crice009/CountertopIncubator/docs/images/render1.png

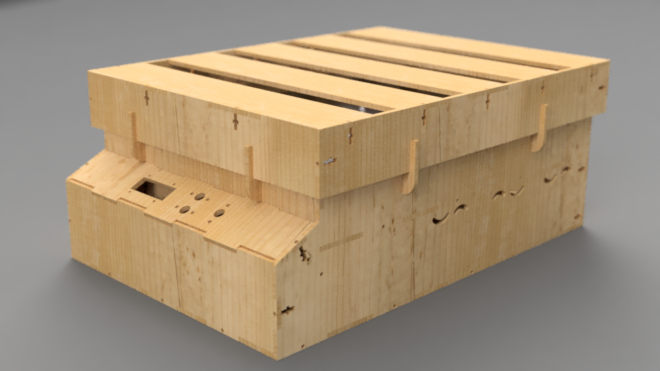
docs/images/render1.png
