crice009/CountertopIncubator/docs/images/pic1.jpg

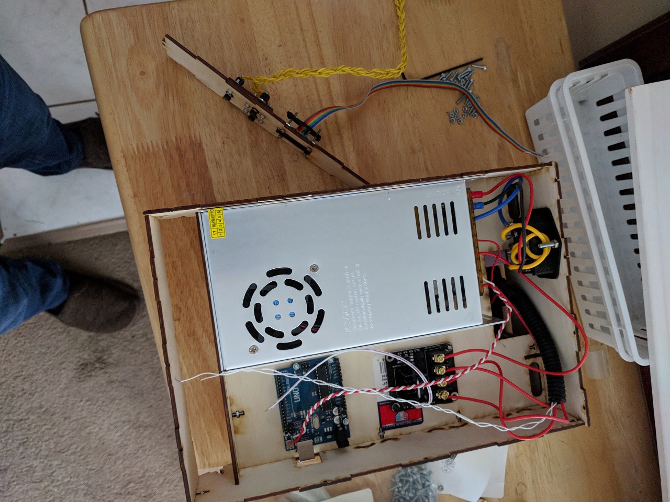
docs/images/pic1.jpg
