crice009/CountertopIncubator/README.md

# Countertop Incubator
Incubator for making tempeh built from spare 3D printer parts. Specifically designed to meet the discerning needs of a hungry girlfriend, with a background in microbiology..

# Documentation Website
https://crice009.github.io/CountertopIncubator/index.html
