crice009/CountertopIncubator/docs/images/1image.png

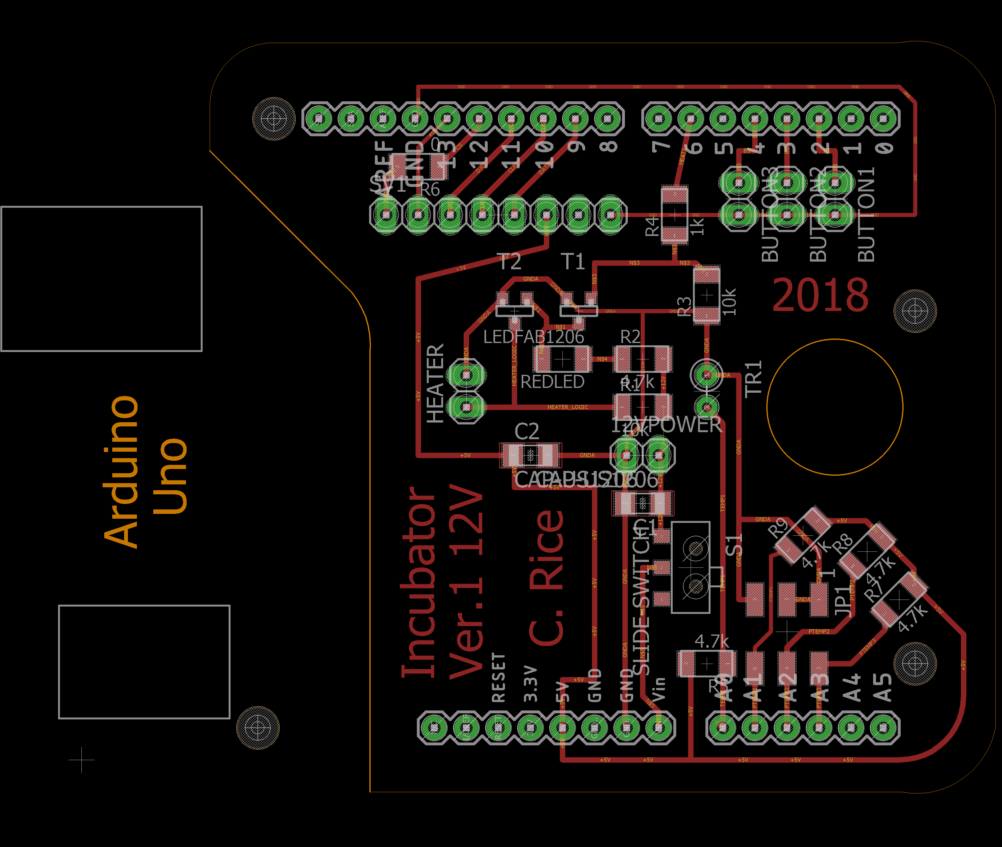
docs/images/1image.png
