crice009/CountertopIncubator/docs/images/dxf_export.png

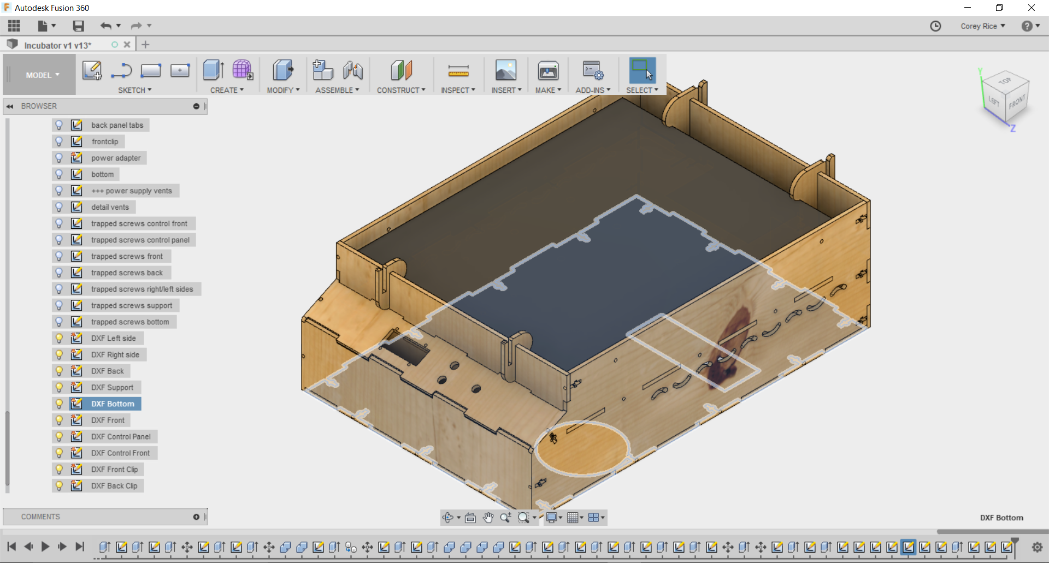
docs/images/dxf_export.png
