crice009/CountertopIncubator/docs/images/gitmarlin.png

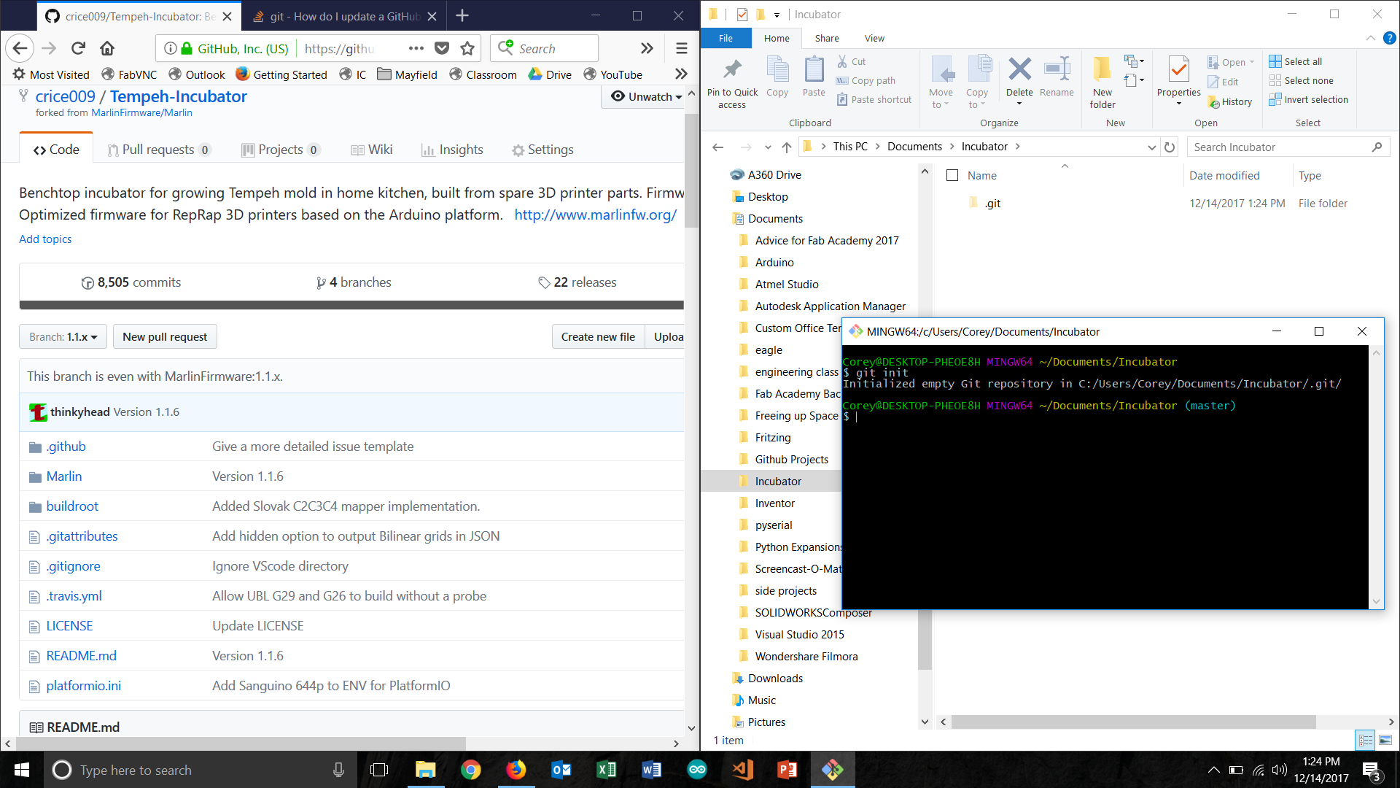
docs/images/gitmarlin.png
