crice009/CountertopIncubator/docs/images/gotmarlin.png

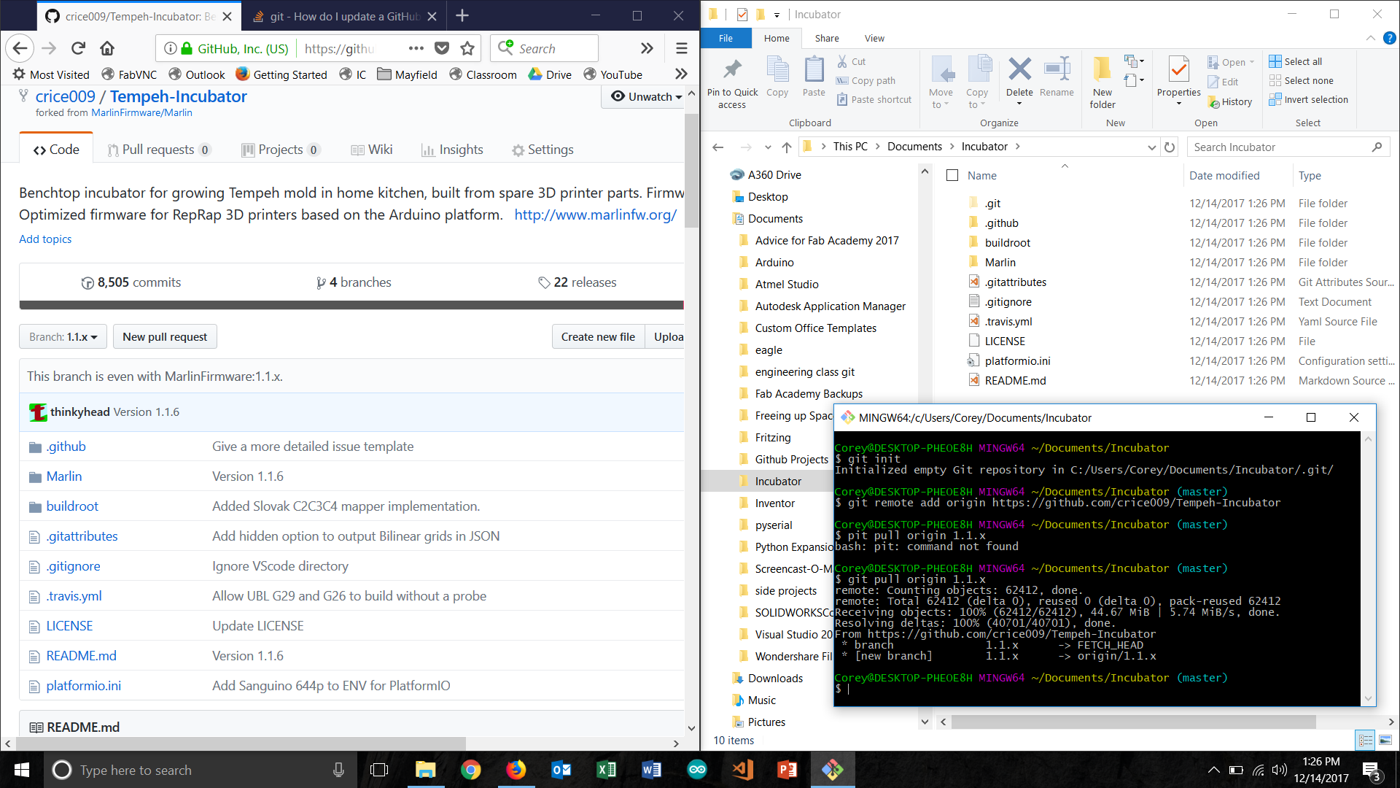
docs/images/gotmarlin.png
