crice009/CountertopIncubator/docs/images/modeling.PNG

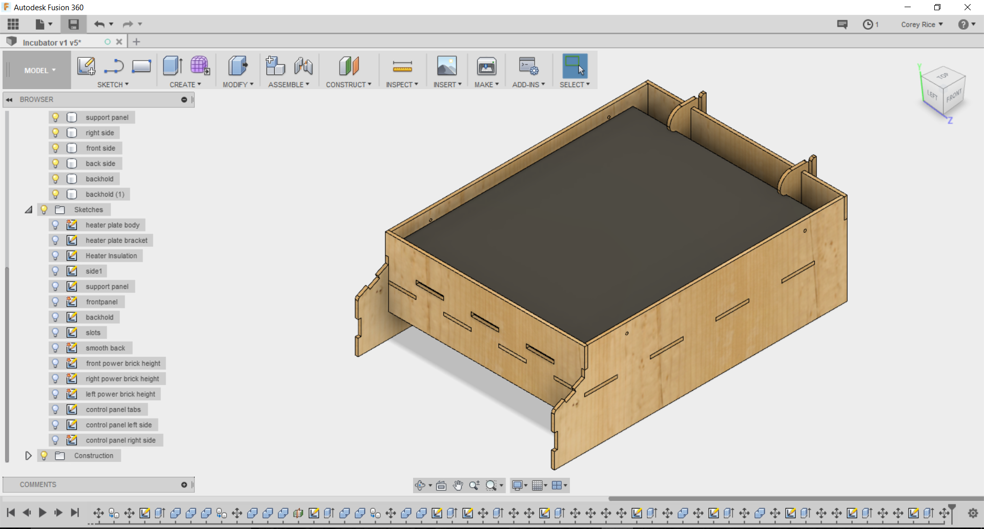
docs/images/modeling.PNG
