crice009/CountertopIncubator/docs/images/pic2.jpg

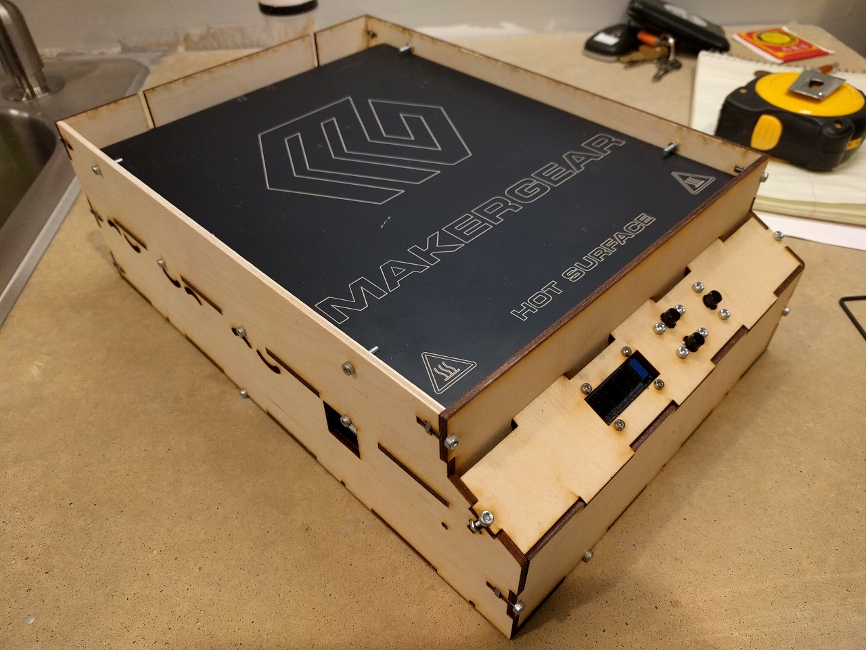
docs/images/pic2.jpg
