crice009/CountertopIncubator/docs/images/render2.png

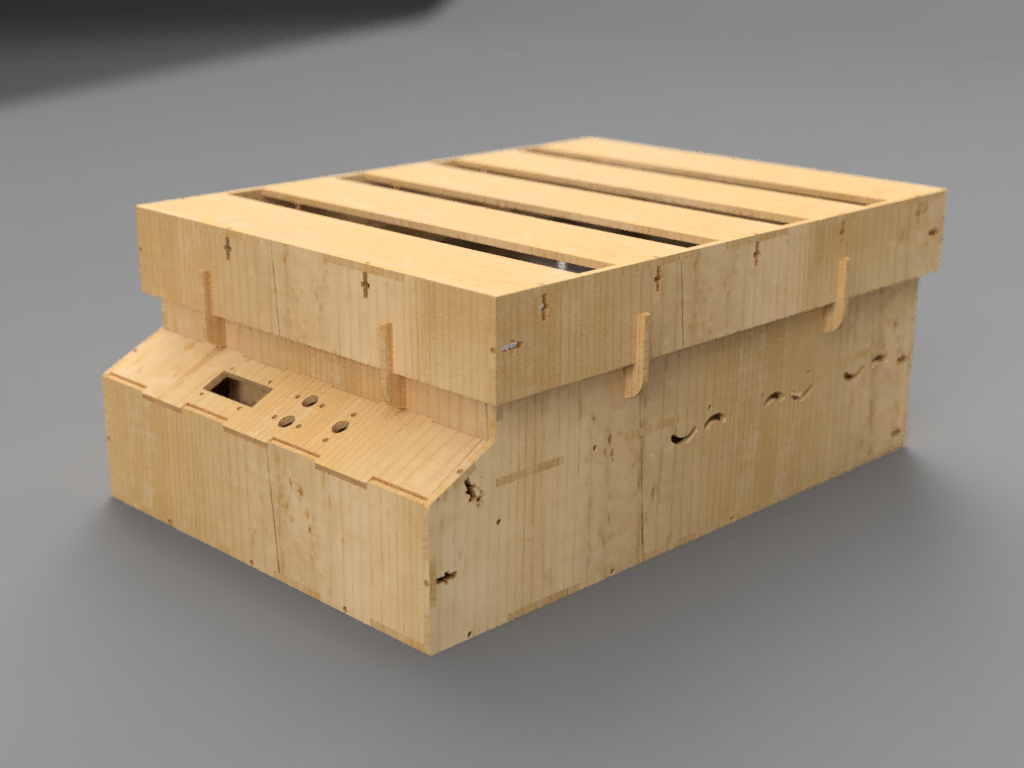
docs/images/render2.png
