crice009/CountertopIncubator/Eagle/design ideas/heated bed circuit (1).png

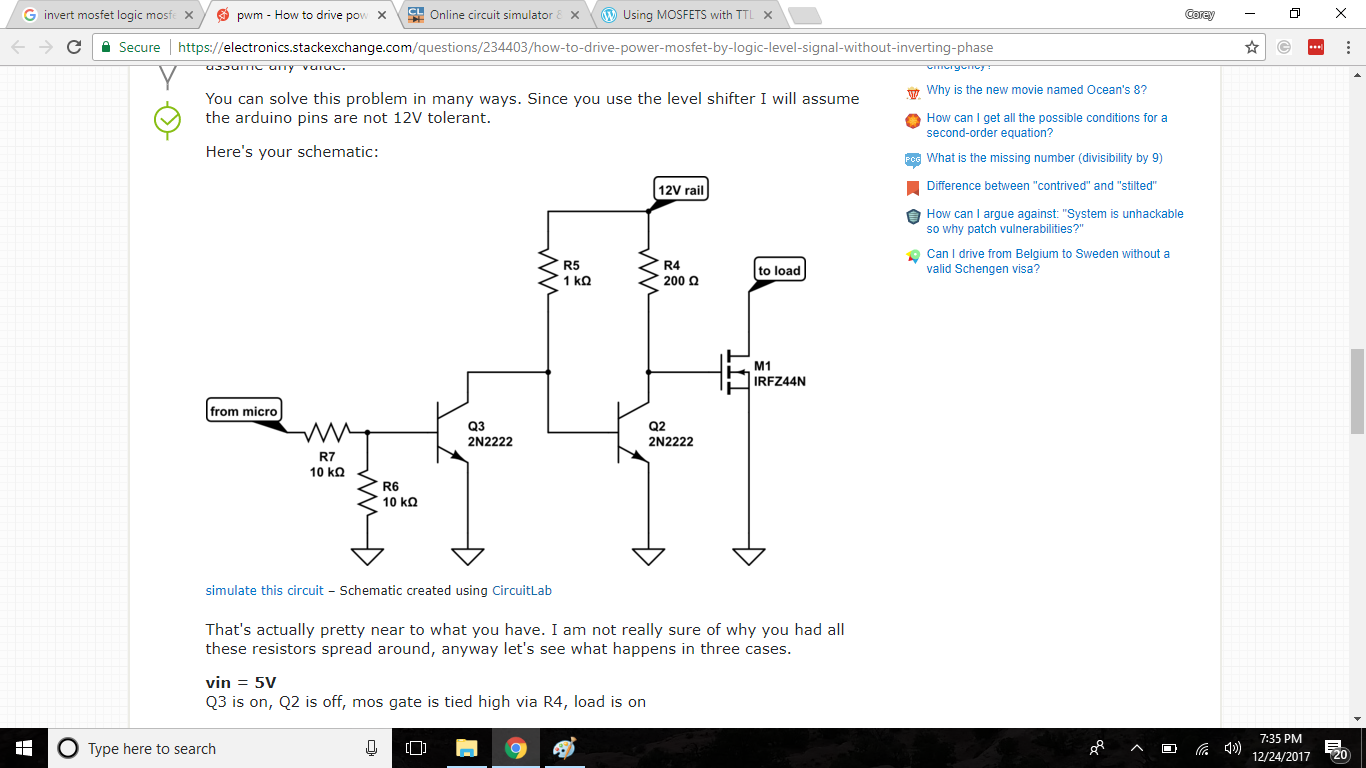
Eagle/design ideas/heated bed circuit (1).png
