crice009/CountertopIncubator/Eagle/design ideas/heated bed circuit (2).png

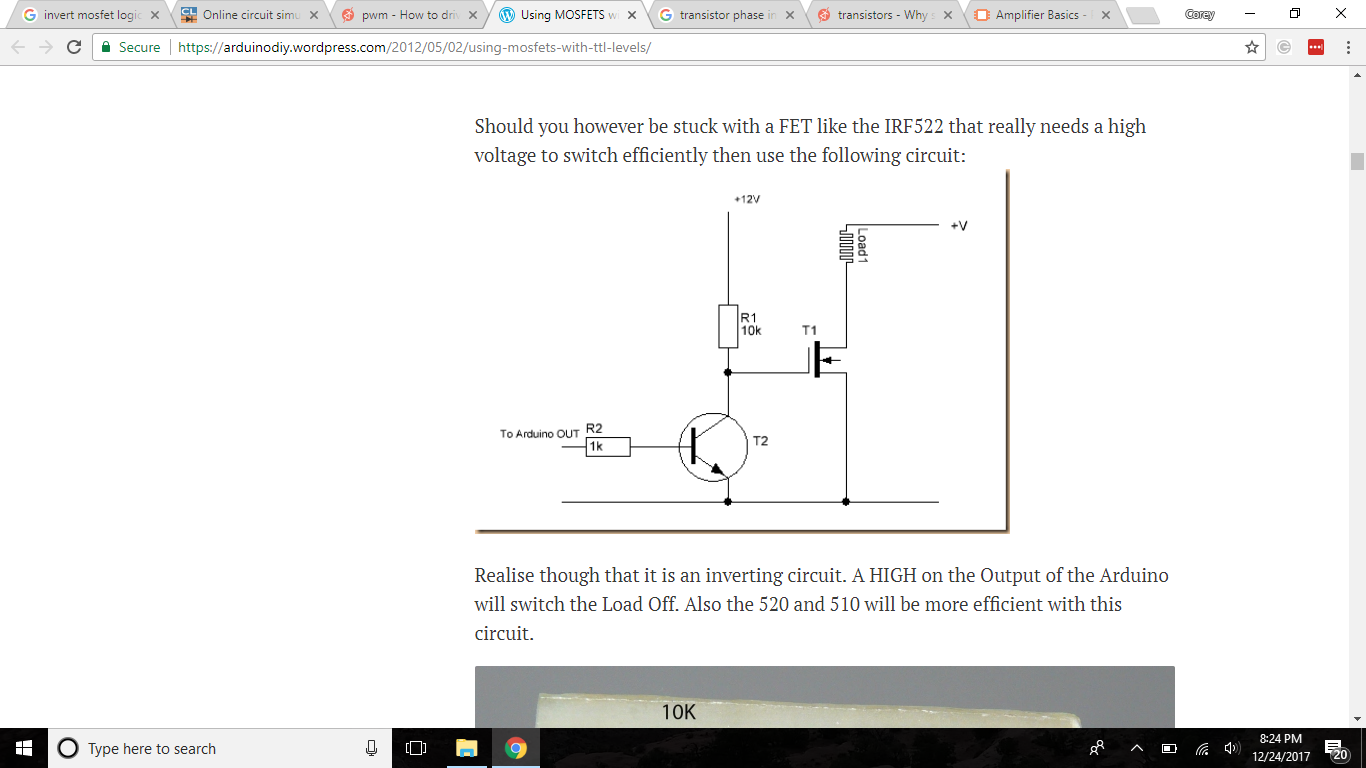
Eagle/design ideas/heated bed circuit (2).png
