crice009/CountertopIncubator/Eagle/design ideas/heated bed circuit.png

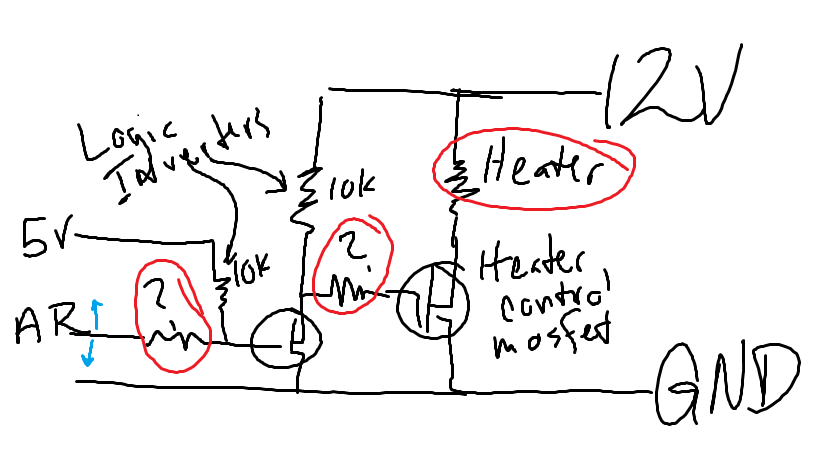
Eagle/design ideas/heated bed circuit.png
