crice009/CountertopIncubator/Eagle/toolpaths/holes.png

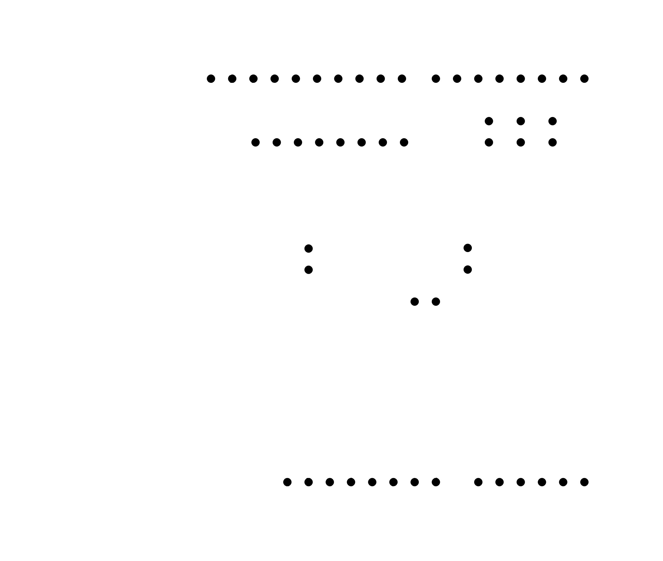
Eagle/toolpaths/holes.png
