crice009/CountertopIncubator/Eagle/toolpaths/outline.png

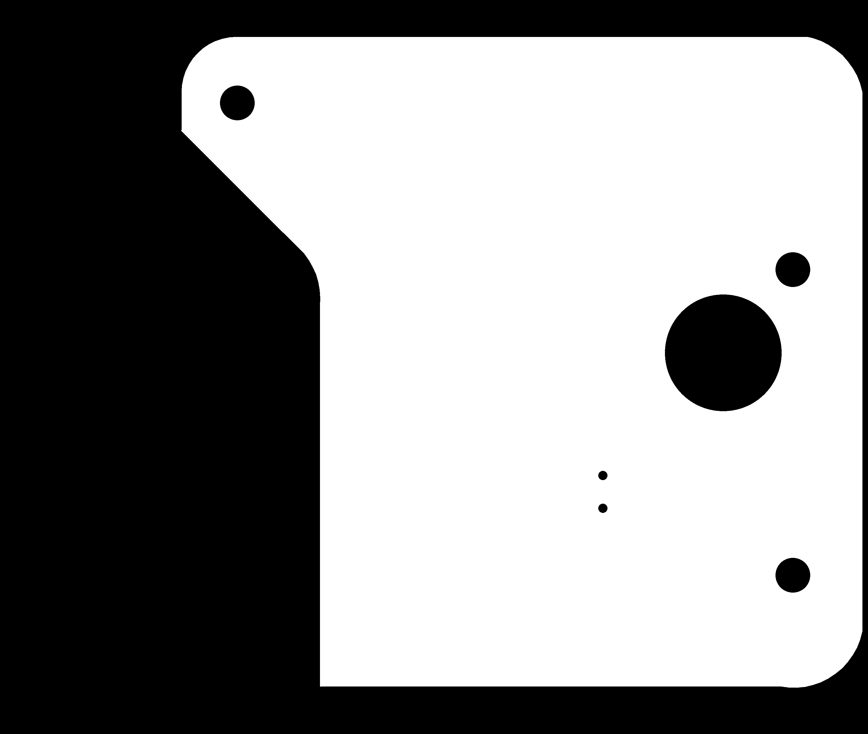
Eagle/toolpaths/outline.png
