crice009/CountertopIncubator/Eagle/toolpaths/traces.png

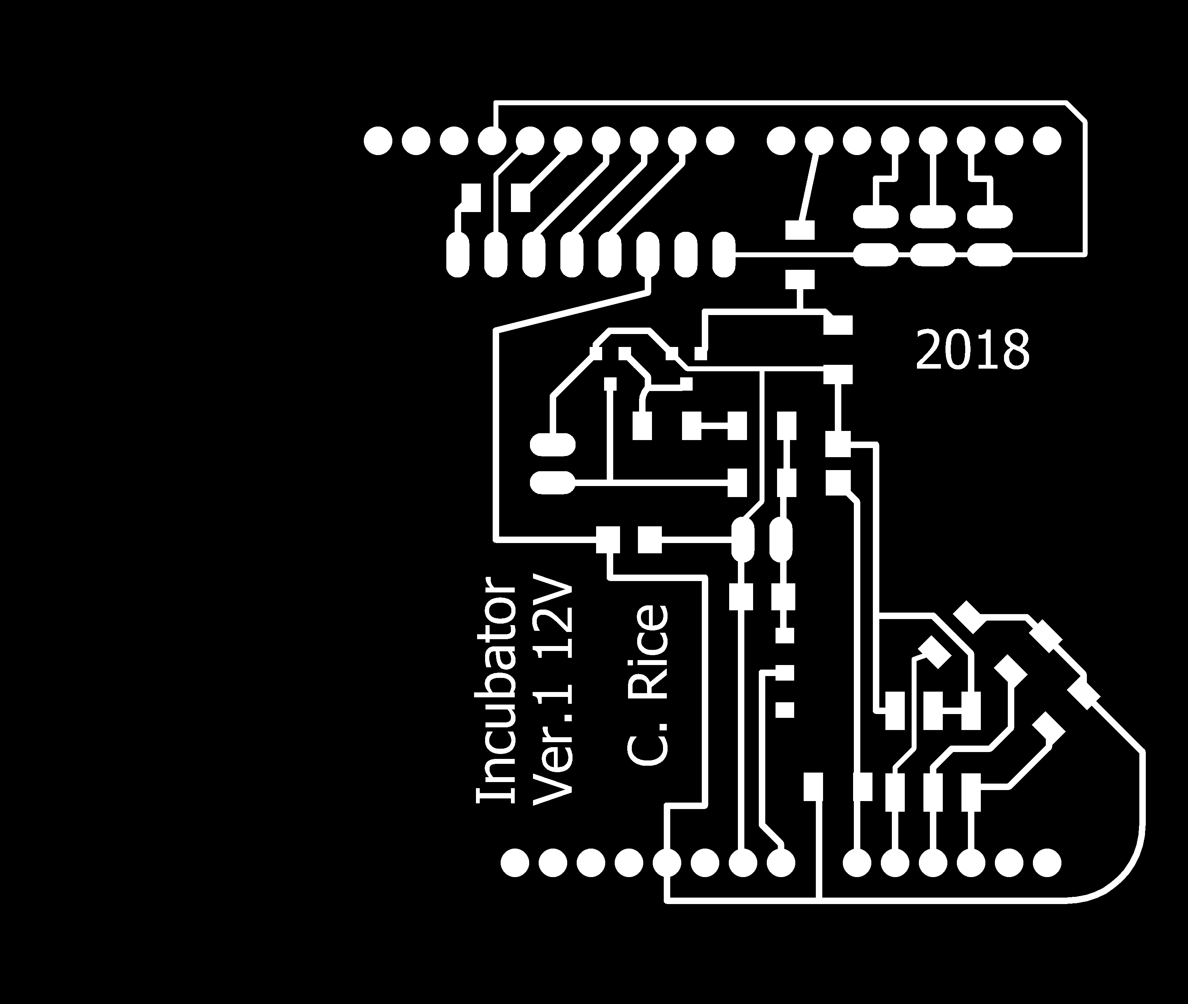
Eagle/toolpaths/traces.png
