crice009/CountertopIncubator/Models/DXF_files/DXF_Bottom3.dxf

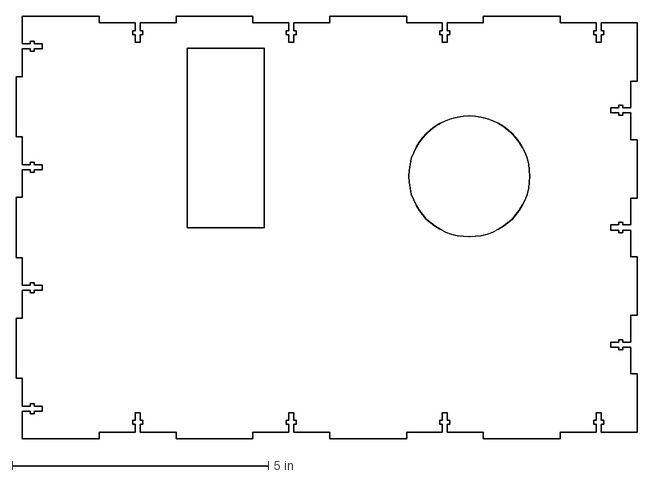
[picture p16: CAD file, 2017-12-29]
Models/DXF_files/DXF_Bottom3.dxf
12.1 x 8.25 in
