crice009/CountertopIncubator/Models/DXF_files/v1/DXF_Bottom.dxf

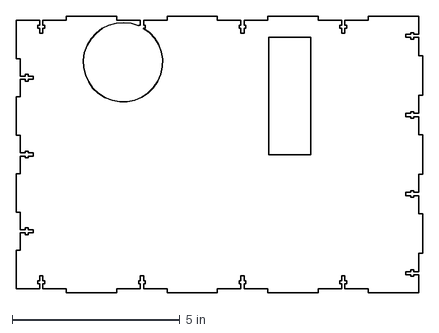
[picture p17: CAD file, 2017-12-29]
Models/DXF_files/v1/DXF_Bottom.dxf
12.1 x 8.25 in
