crice009/CountertopIncubator/Models/DXF_files/v1/DXF_Right.dxf

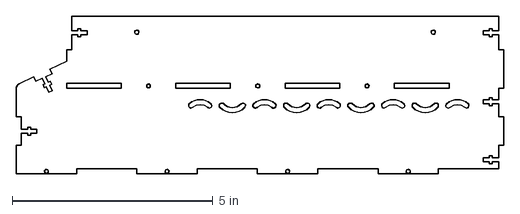
[picture p21: CAD file, 2017-12-29]
Models/DXF_files/v1/DXF_Right.dxf
12.1 x 3.92 in
