crice009/CountertopIncubator/Models/DXF_files/DXF_Left.dxf

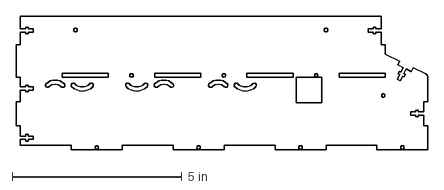
[picture p22: CAD file, 2017-12-29]
Models/DXF_files/DXF_Left.dxf
12.1 x 3.92 in
