crice009/CountertopIncubator/Models/DXF_files/v1/DXF_Back_Clip_2x.dxf

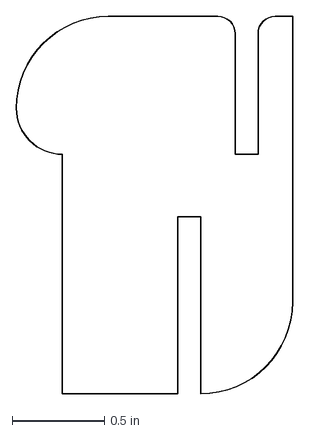
[picture p23: CAD file, 2017-12-29]
Models/DXF_files/v1/DXF_Back_Clip_2x.dxf
1.50 x 2.05 in
