crice009/CountertopIncubator/Models/DXF_files/DXF_Front2.dxf

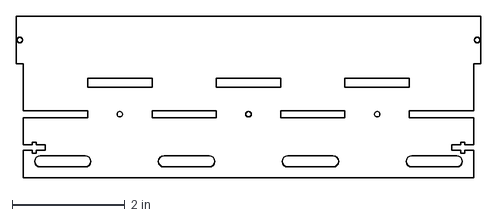
[picture p24: CAD file, 2017-12-29]
Models/DXF_files/DXF_Front2.dxf
8.25 x 2.86 in
