crice009/CountertopIncubator/Models/DXF_files/v1/DXF_Back.dxf

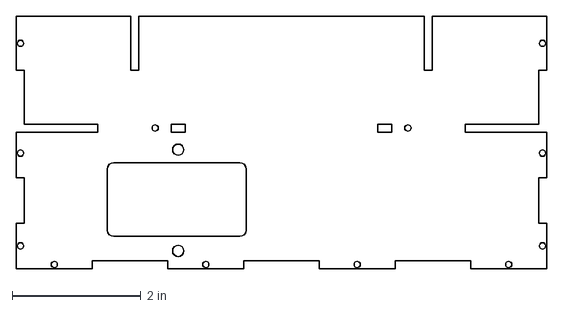
[picture p25: CAD file, 2017-12-29]
Models/DXF_files/v1/DXF_Back.dxf
8.25 x 3.92 in
