crice009/CountertopIncubator/Models/DXF_files/DXF_Support.dxf

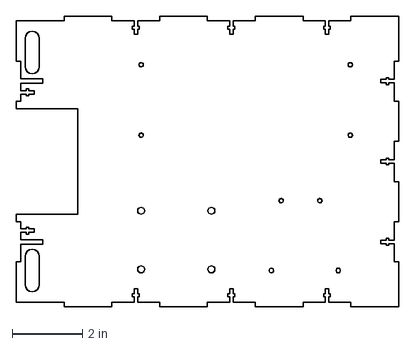
[picture p26: CAD file, 2017-12-29]
Models/DXF_files/DXF_Support.dxf
10.9 x 8.25 in
