crice009/CountertopIncubator/Models/DXF_files/v1/DXF_Control_Panel.dxf

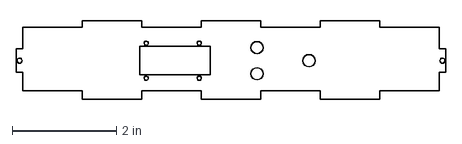
[picture p27: CAD file, 2017-12-29]
Models/DXF_files/v1/DXF_Control_Panel.dxf
8.25 x 1.50 in
