crice009/CountertopIncubator/Models/DXF_files/DXF_Front.dxf

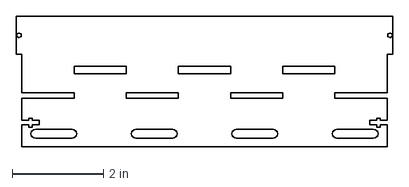
[picture p29: CAD file, 2017-12-29]
Models/DXF_files/DXF_Front.dxf
8.25 x 2.86 in
