crice009/CountertopIncubator/Models/DXF_files/DXF_Button_Panel.dxf

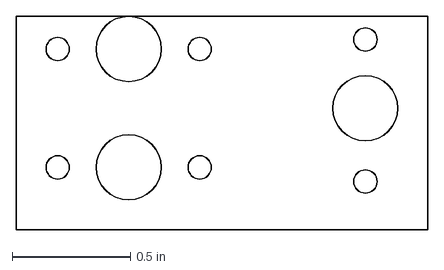
[picture p31: CAD file, 2017-12-29]
Models/DXF_files/DXF_Button_Panel.dxf
1.74 x 0.901 in
