crice009/CountertopIncubator/Models/DXF_files/v1/DXF_Front.dxf

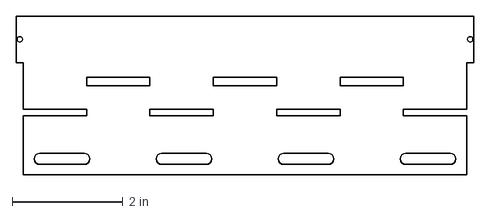
[picture p32: CAD file, 2017-12-29]
Models/DXF_files/v1/DXF_Front.dxf
8.25 x 2.86 in
