crice009/CountertopIncubator/Models/DXF_files/v1/DXF_Front_Clip_2x+.dxf

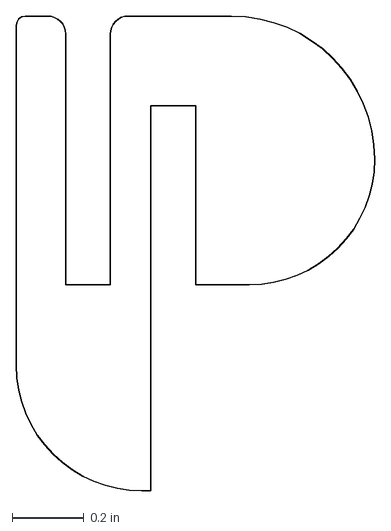
[picture p34: CAD file, 2017-12-29]
Models/DXF_files/v1/DXF_Front_Clip_2x+.dxf
1.00 x 1.33 in
