crice009/CountertopIncubator/Models/DXF_files/DXF_lid_long.dxf

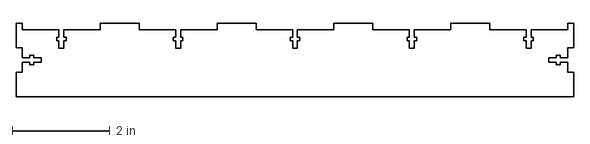
[picture p35: CAD file, 2017-12-29]
Models/DXF_files/DXF_lid_long.dxf
11.4 x 1.50 in
