crice009/CountertopIncubator/Models/DXF_files/DXF_Control_Front.dxf

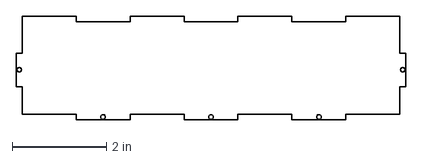
[picture p36: CAD file, 2017-12-29]
Models/DXF_files/DXF_Control_Front.dxf
8.25 x 2.20 in
