crice009/CountertopIncubator/Models/DXF_files/DXF_lid_short.dxf

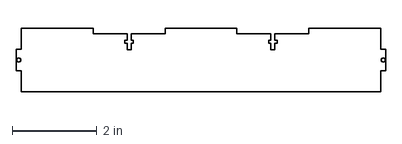
[picture p37: CAD file, 2017-12-29]
Models/DXF_files/DXF_lid_short.dxf
8.73 x 1.50 in
