crice009/CountertopIncubator/Models/DXF_files/DXF_Control_Panel2.dxf

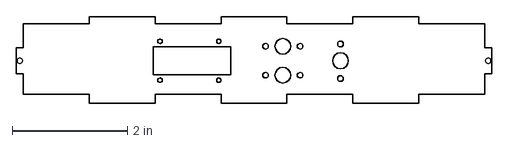
[picture p38: CAD file, 2017-12-29]
Models/DXF_files/DXF_Control_Panel2.dxf
8.25 x 1.50 in
