crice009/CountertopIncubator/Models/DXF_files/DXF_Back_Clip.dxf

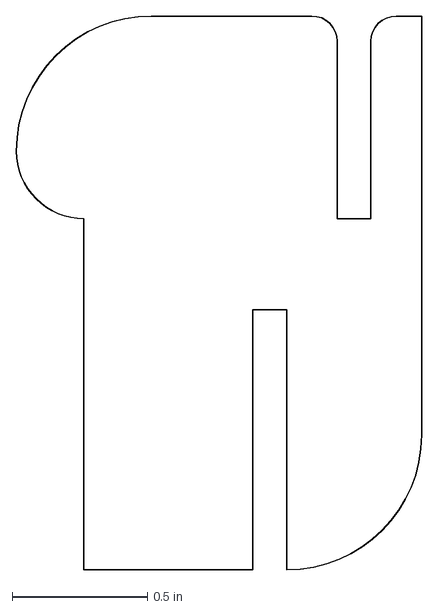
[picture p39: CAD file, 2017-12-29]
Models/DXF_files/DXF_Back_Clip.dxf
1.50 x 2.05 in
