crice009/CountertopIncubator/Models/DXF_files/DXF_Front_Clip.dxf

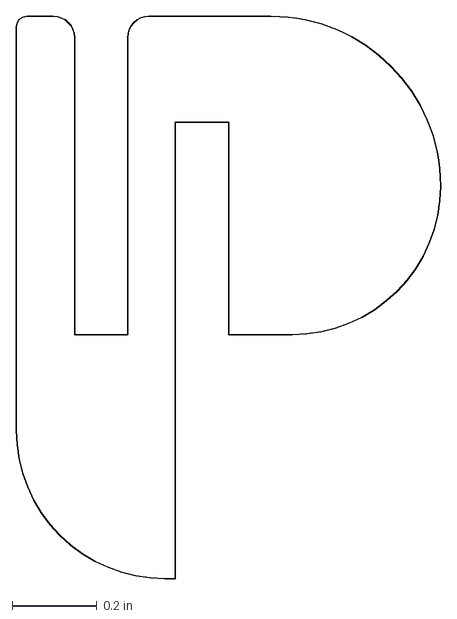
[picture p41: CAD file, 2017-12-29]
Models/DXF_files/DXF_Front_Clip.dxf
1.00 x 1.33 in
