crice009/CountertopIncubator/Models/DXF_files/DXF_lid_mid.dxf

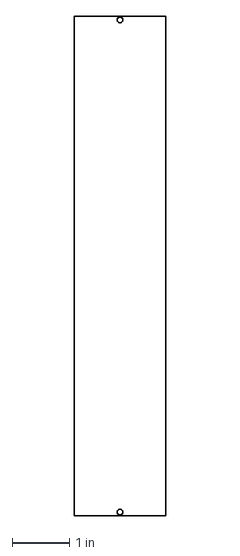
[picture p43: CAD file, 2017-12-29]
Models/DXF_files/DXF_lid_mid.dxf
1.60 x 8.72 in
