crice009/CountertopIncubator/Models/DXF_files/DXF_lid_end.dxf

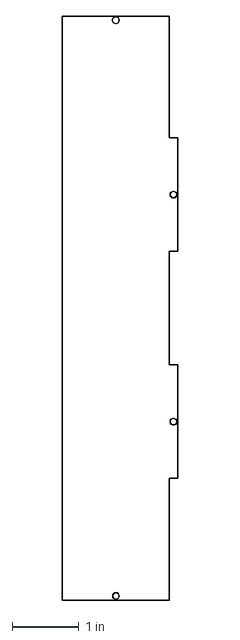
[picture p44: CAD file, 2017-12-29]
Models/DXF_files/DXF_lid_end.dxf
1.72 x 8.72 in
