crice009/CountertopIncubator/Models/DXF_files/DXF_Bottom.dxf

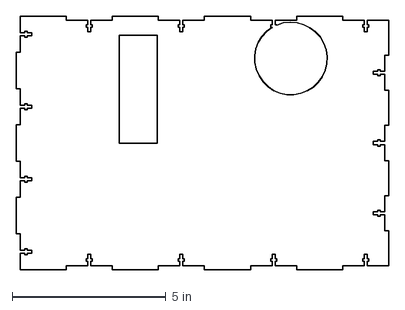
[picture p45: CAD file, 2017-12-29]
Models/DXF_files/DXF_Bottom.dxf
12.1 x 8.25 in
