crice009/CountertopIncubator/Firmware/Arduino/0examples/zMakerGearM2(marlin)/M2E-Production-SnNRd-V100/README.md

# Marlin 3D Printer Firmware


 Documentation has moved to [marlinfirmware.org](http://www.marlinfirmware.org).

## Release Branch

The Release branch contains the latest tagged version of Marlin (currently 1.0.2 – January 2015). It also includes a version 1.0.1 (December 2014). Any version of Marlin before 1.0.1 (when we started tagging versions) can be collectively referred to as Marlin 1.0.0.

For the most up-to-date Marlin code, please go to the [Development branch](https://github.com/MarlinFirmware/Marlin/tree/Development) – __Not for production use – use with caution!__ When reporting any issues, please check to see if they are resolved in the Development branch first. But let us know if issues exist in tagged releases so we may document and patch them.

## Current Status: In Development

Marlin development is being accelerated to catch up with a long list of issues. Check the Issues and Pull Requests links on the right to to see what we are currently working on.




##### [RepRap.org Wiki Page](http://reprap.org/wiki/Marlin)

## Contact

__Google Hangout:__ <a href="https://plus.google.com/hangouts/_/gxn3wrea5gdhoo223yimsiforia" target="_blank">. Hangout</a> We have a hangout every 2 weeks. Search the issue list for "Hangout" and you will see what time and date the next event is going on.

## Credits

The current Marlin dev team consists of:

 - Scott Lahteine [@thinkyhead] - English
 - Andreas Hardtung [@AnHardt] - Deutsch, English
 - [@Wurstnase] - Deutsch, English
 - [@fmalpartida] - English, Spanish
 - [@CONSULitAS] - Deutsch, English
 - [@maverikou]
 - Chris Palmer [@nophead]
 - [@paclema]
 - [@epatel]
 - Erik van der Zalm [@ErikZalm]
 - David Braam [@daid]
 - Bernhard Kubicek [@bkubicek]

More features have been added by:
  - Lampmaker,
  - Bradley Feldman,
  - and others...

## License

Marlin is published under the [GPL license](/Documentation/COPYING.md) because We believe in open development.
Do not use this code in products (3D printers, CNC etc) that are closed source or are crippled by a patent.
