crice009/CountertopIncubator/docs/images/incubatorShieldSMD.pdf

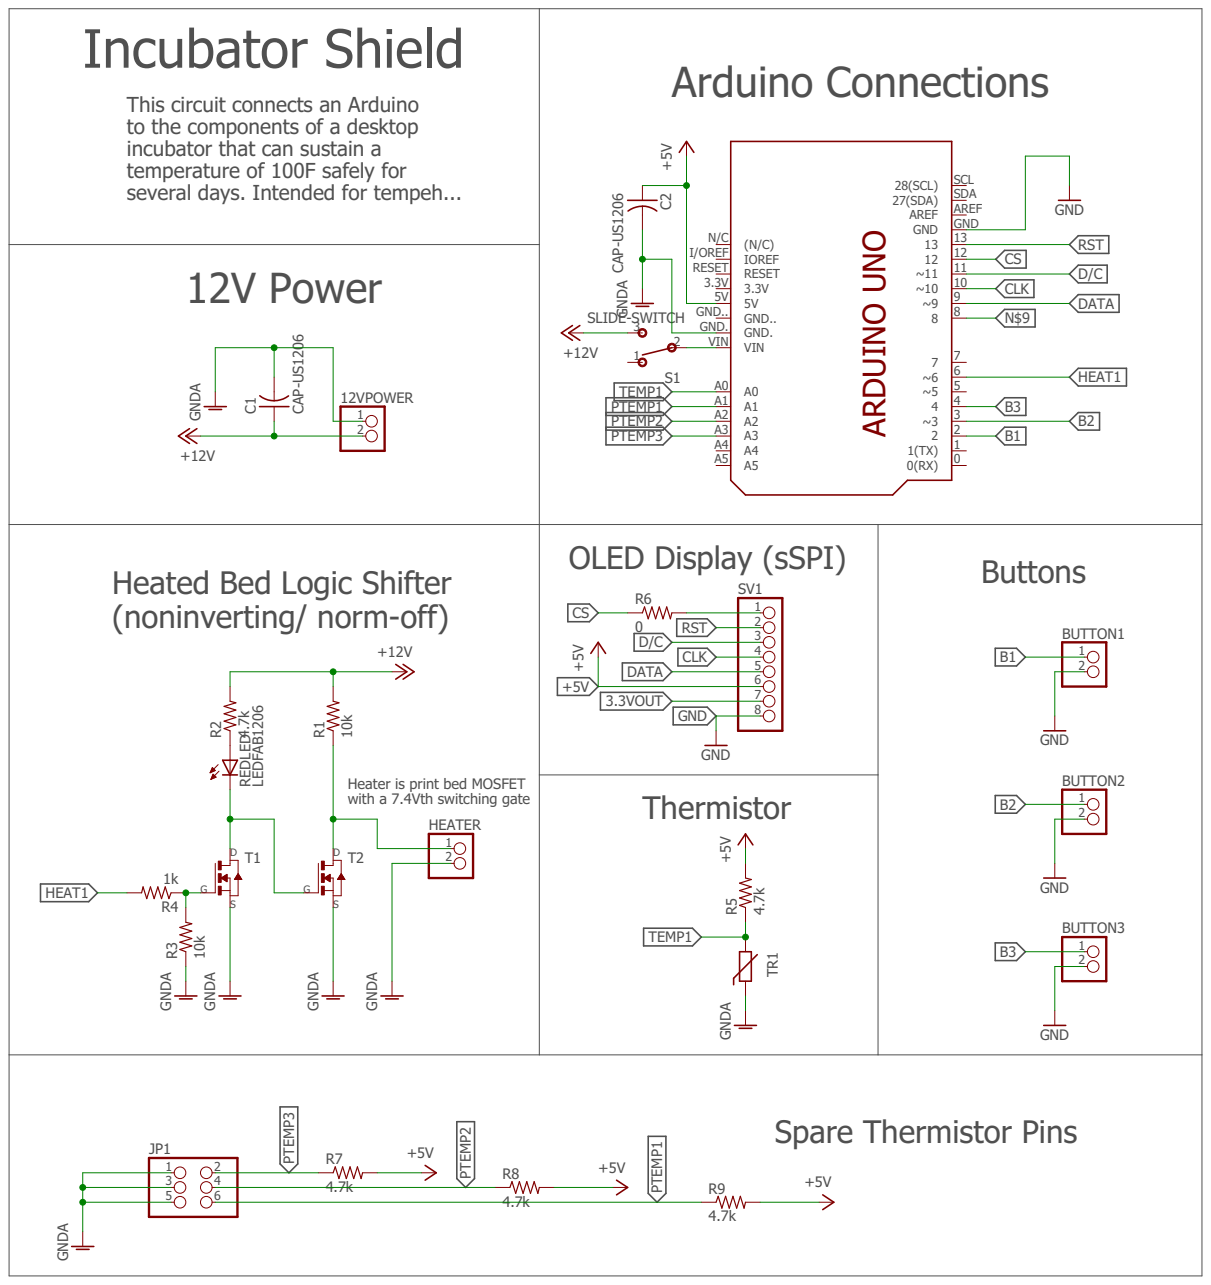
[picture p46: page 1]

This circuit connects an Arduino
to the components of a desktop
incubator that can sustain a
temperature of 100F safely for

OLED Display (sSPI) Heated Bed Logic Shifter

Heater is print bed MOSFET with a 7.4Vth switching gate

GNDA GNDA
