crice009/CountertopIncubator/Eagle/zOldVersions/otherComputer/shield.brd

## EAGLE design Eagle/zOldVersions/otherComputer/shield.brd (2017-12-29, an earlier design)

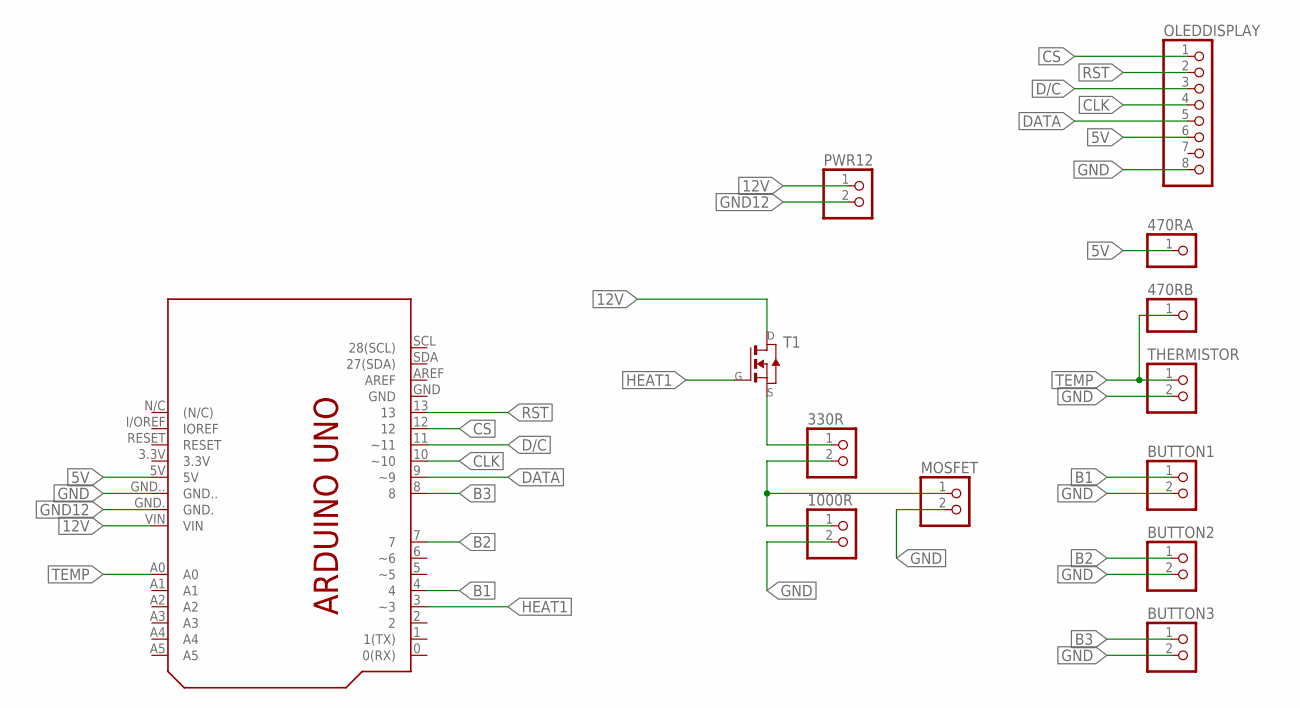
[picture p47: schematic shield.sch]

Parts:
330R, 1000R: PINHD-1X2; 1X02
470RA, 470RB: PINHD-1X1; 1X01
BUTTON1, BUTTON2, BUTTON3: PINHD-1X2; 1X02
MOSFET: PINHD-1X2; 1X02
OLEDDISPLAY: PINHD-1X8; 1X08
PCB1: ARDUINO_UNO_UNBOUND
PWR12: PINHD-1X2; 1X02
T1: NMOSFETTO252; TO252
THERMISTOR: PINHD-1X2; 1X02

Connections:
5V: 470RA.1, OLEDDISPLAY.6, PCB1.5V
12V: PCB1.VIN, PWR12.1, T1.3 (D)
B1: BUTTON1.1, PCB1.4
B2: BUTTON2.1, PCB1.7
B3: BUTTON3.1, PCB1.8
CLK: OLEDDISPLAY.4, PCB1.10 (~10)
CS: OLEDDISPLAY.1, PCB1.12
D/C: OLEDDISPLAY.3, PCB1.11 (~11)
DATA: OLEDDISPLAY.5, PCB1.9 (~9)
GND: 1000R.2, BUTTON1.2, BUTTON2.2, BUTTON3.2, MOSFET.2, OLEDDISPLAY.8, PCB1.GND.., THERMISTOR.2
GND12: PCB1.GND., PWR12.2
HEAT1: PCB1.3 (~3), T1.1 (G)
unnamed: 330R.2, 1000R.1, MOSFET.1
unnamed: 330R.1, T1.2 (S)
RST: OLEDDISPLAY.2, PCB1.13
TEMP: 470RB.1, PCB1.A0, THERMISTOR.1

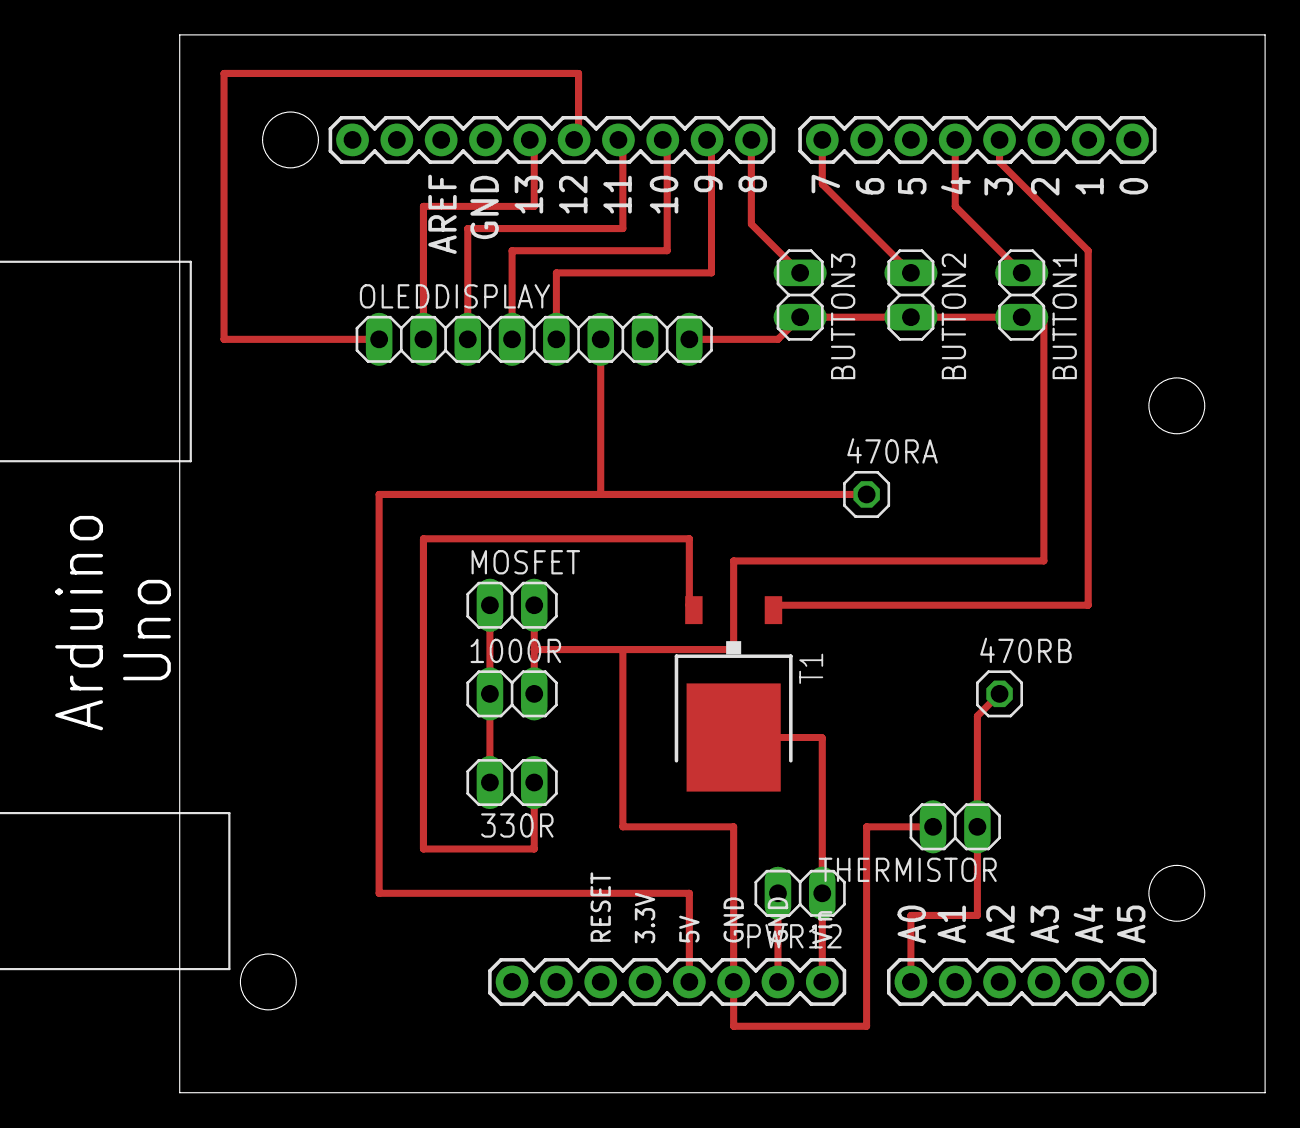
[picture p48: board shield.brd from above]

Board: 2 copper layers, 62.2 x 60.6 mm, 13 parts (0 on the bottom side), 16 nets.
