crice009/CountertopIncubator/Eagle/incubatorShieldSMD.brd

## EAGLE design Eagle/incubatorShieldSMD.brd (2017-12-29)

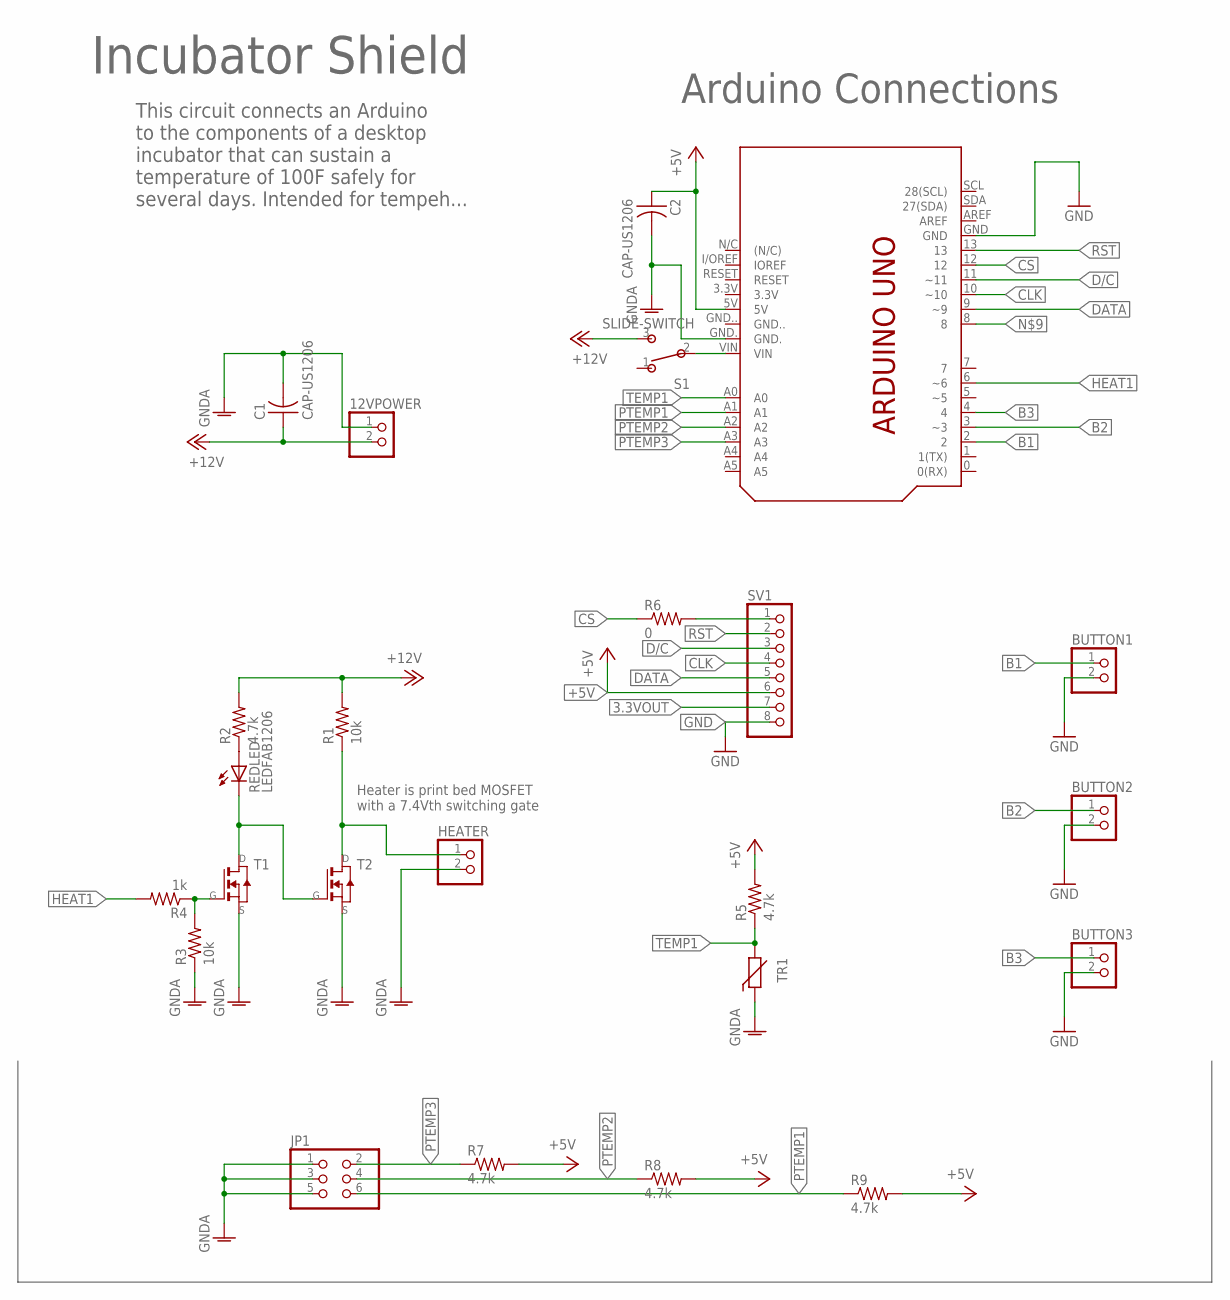
[picture p49: schematic incubatorShieldSMD.sch, In/Out Circuits of the Incubator shield]

Parts:
12VPOWER: PINHD-1X2; 1X02
BUTTON1, BUTTON2, BUTTON3: PINHD-1X2; 1X02
C1, C2: CAP-US1206; C1206
HEATER: PINHD-1X2; 1X02
JP1: PINHD-2X3-SMD; 2X03SMD
R1, R3: 10k; R1206FAB
R2, R5, R7, R8, R9: 4.7k; R1206FAB
R4: 1k; R1206FAB
R6: 0; R1206FAB
REDLED: LEDFAB1206; LED1206FAB
S1: SLIDE-SWITCH; AYZ0102AGRLC
SV1: PINHD-1X8; 1X08
T1, T2: NMOSFETSOT23; SOT-23
TR1: THERMISTOR_R-2,5; RS-2,5
U$2: ARDUINO_UNO_UNBOUND

Connections:
3.3VOUT: SV1.7
+5V: C2.1, R5.2, R7.2, R8.2, R9.2, SV1.6, U$2.5V
+12V: 12VPOWER.2, C1.1, R1.2, R2.2, S1.3
B1: BUTTON1.1, U$2.2
B2: BUTTON2.1, U$2.3 (~3)
B3: BUTTON3.1, U$2.4
CLK: SV1.4, U$2.10 (~10)
CS: R6.1, U$2.12
D/C: SV1.3, U$2.11 (~11)
DATA: SV1.5, U$2.9 (~9)
GND: BUTTON1.2, BUTTON2.2, BUTTON3.2, SV1.8, U$2.GND
GNDA: 12VPOWER.1, C1.2, C2.2, HEATER.2, JP1.1, JP1.3, JP1.5, R3.1, T1.2 (S), T2.2 (S), TR1.1, U$2.GND.
HEAT1: R4.2, U$2.6 (~6)
HEATER_LOGIC: HEATER.1, R1.1, T2.1 (D)
unnamed: REDLED.2 (C), T1.1 (D), T2.3 (G)
unnamed: R6.2, SV1.1
unnamed: R3.2, R4.1, T1.3 (G)
unnamed: R2.1, REDLED.1 (A)
unnamed: S1.2, U$2.VIN
PTEMP1: JP1.6, R9.1, U$2.A1
PTEMP2: JP1.4, R8.1, U$2.A2
PTEMP3: JP1.2, R7.1, U$2.A3
RST: SV1.2, U$2.13
TEMP1: R5.1, TR1.2, U$2.A0

Notes on the sheet:
Heater is print bed MOSFET with a 7.4Vth switching gate
Incubator Shield
This circuit connects an Arduino to the components of a desktop incubator that can sustain a temperature of 100F safely for several days. Intended for tempeh...
Arduino Connections

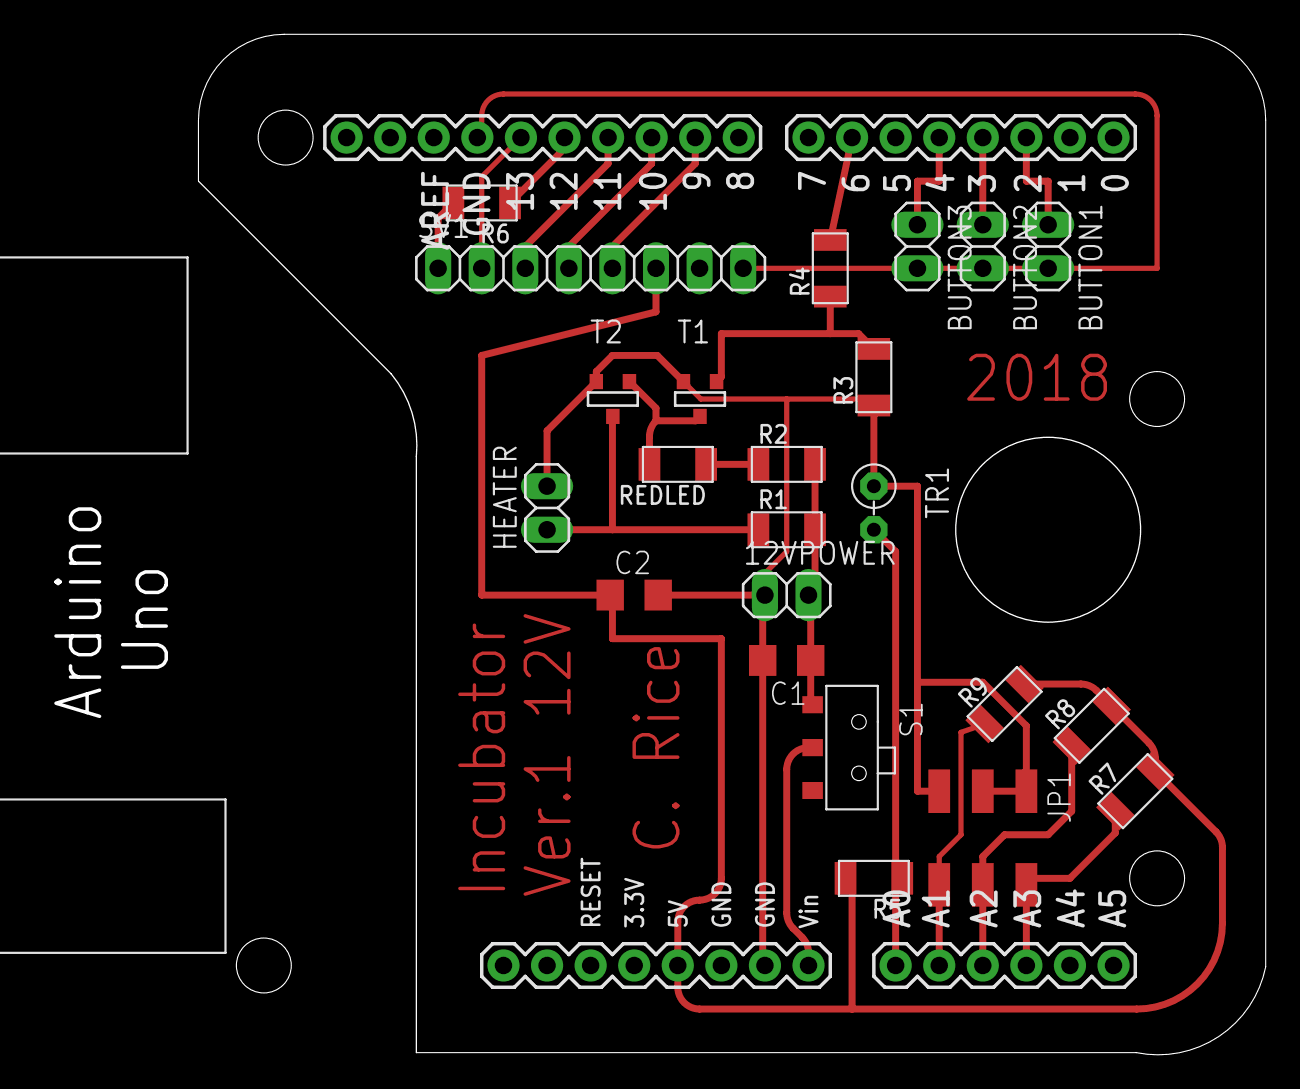
[picture p50: board incubatorShieldSMD.brd from above]

Board: 2 copper layers, 62.2 x 59.5 mm, 24 parts (0 on the bottom side), 23 nets.
