crice009/CountertopIncubator/Firmware/Arduino/2comboPartsTests/tempTest3/thermistortables.h

#ifndef THERMISTORTABLES_H_
#define THERMISTORTABLES_H_

long BEDTEMPTABLE_LEN = 61;

#define OVERSAMPLENR 16

#if (THERMISTORHEATER_0 == 1) || (THERMISTORHEATER_1 == 1)  || (THERMISTORHEATER_2 == 1) || (THERMISTORBED == 1) //100k bed thermistor

#define BEDTEMPTABLE_LEN 61
const short temptable_1[][2] PROGMEM = {
{       23*OVERSAMPLENR ,       300     },        
{       25*OVERSAMPLENR ,       295     },
{       27*OVERSAMPLENR ,       290     },
{       28*OVERSAMPLENR ,       285     },
{       31*OVERSAMPLENR ,       280     },
{       33*OVERSAMPLENR ,       275     },
{       35*OVERSAMPLENR ,       270     },
{       38*OVERSAMPLENR ,       265     },
{       41*OVERSAMPLENR ,       260     },
{       44*OVERSAMPLENR ,       255     },
{       48*OVERSAMPLENR ,       250     },
{       52*OVERSAMPLENR ,       245     },
{       56*OVERSAMPLENR ,       240     },
{       61*OVERSAMPLENR ,       235     },
{       66*OVERSAMPLENR ,       230     },
{       71*OVERSAMPLENR ,       225     },
{       78*OVERSAMPLENR ,       220     },
{       84*OVERSAMPLENR ,       215     },
{       92*OVERSAMPLENR ,       210     },
{       100*OVERSAMPLENR        ,       205     },
{       109*OVERSAMPLENR        ,       200     },
{       120*OVERSAMPLENR        ,       195     },
{       131*OVERSAMPLENR        ,       190     },
{       143*OVERSAMPLENR        ,       185     },
{       156*OVERSAMPLENR        ,       180     },
{       171*OVERSAMPLENR        ,       175     },
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
#  define HEATER_2_RAW_HI_TEMP 0
#  define HEATER_2_RAW_LO_TEMP 16383
# else                          //In case of an thermocouple the highest temperature results in the highest ADC value
#  define HEATER_2_RAW_HI_TEMP 16383
#  define HEATER_2_RAW_LO_TEMP 0
# endif
#endif

#ifdef THERMISTORBED
# define BEDTEMPTABLE TT_NAME(THERMISTORBED)
# define BEDTEMPTABLE_LEN (sizeof(BEDTEMPTABLE)/sizeof(*BEDTEMPTABLE))
#else
# ifdef BED_USES_THERMISTOR
#  error No bed thermistor table specified
# endif // BED_USES_THERMISTOR
#endif

//Set the high and low raw values for the heater, this indicates which raw value is a high or low temperature
#ifndef HEATER_BED_RAW_HI_TEMP
# ifdef BED_USES_THERMISTOR   //In case of a thermistor the highest temperature results in the lowest ADC value
#  define HEATER_BED_RAW_HI_TEMP 0
#  define HEATER_BED_RAW_LO_TEMP 16383
# else                          //In case of an thermocouple the highest temperature results in the highest ADC value
#  define HEATER_BED_RAW_HI_TEMP 16383
#  define HEATER_BED_RAW_LO_TEMP 0
# endif
#endif

#endif //THERMISTORTABLES_H_
