crice009/CountertopIncubator/Firmware/Arduino/2comboPartsTests/tempTest1/temperature.h

/*
  temperature.h - temperature controller
  Part of Marlin

  Copyright (c) 2011 Erik van der Zalm

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
  You should have received a copy of the GNU General Public License
  along with Grbl.  If not, see <http://www.gnu.org/licenses/>.
*/

#ifndef temperature_h
#define temperature_h 

// public functions
void tp_init();  //initialize the heating
void manage_heater(); //it is critical that this is called periodically.

// low level conversion routines
// do not use these routines and variables outside of temperature.cpp
extern int target_temperature[PROBES];  
extern float current_temperature[PROBES];
#ifdef SHOW_TEMP_ADC_VALUES
  extern int current_temperature_raw[PROBES];
  extern int current_temperature_bed_raw;
#endif

extern int target_temperature_bed;
extern float current_temperature_bed;

#ifdef TEMP_SENSOR_1_AS_REDUNDANT
  extern float redundant_temperature;
#endif

#if defined(CONTROLLERFAN_PIN) && CONTROLLERFAN_PIN > -1
  extern unsigned char soft_pwm_bed;
#endif

#ifdef PIDTEMP
  extern float Kp,Ki,Kd,Kc;
  float scalePID_i(float i);
  float scalePID_d(float d);
  float unscalePID_i(float i);
  float unscalePID_d(float d);
#endif

#ifdef PIDTEMPBED
  extern float bedKp,bedKi,bedKd;
#endif
  
#ifdef BABYSTEPPING
  extern volatile int babystepsTodo[3];
#endif
  
//high level conversion routines, for use outside of temperature.cpp
//inline so that there is no performance decrease.
//deg=degreeCelsius

inline float degHotend(uint8_t PROBE) {  
  return current_temperature[PROBE];
};

#ifdef SHOW_TEMP_ADC_VALUES
  inline float rawHotendTemp(uint8_t PROBE) {  
    return current_temperature_raw[PROBE];
  };

  inline float rawBedTemp() {  
    return current_temperature_bed_raw;
  };
#endif

inline float degBed() {
  return current_temperature_bed;
};

inline float degTargetHotend(uint8_t PROBE) {  
  return target_temperature[PROBE];
};

inline float degTargetBed() {   
  return target_temperature_bed;
};

inline void setTargetHotend(const float &celsius, uint8_t PROBE) {  
  target_temperature[PROBE] = celsius;
};

inline void setTargetBed(const float &celsius) {  
  target_temperature_bed = celsius;
};

inline bool isHeatingHotend(uint8_t PROBE){  
  return target_temperature[PROBE] > current_temperature[PROBE];
};

inline bool isHeatingBed() {
  return target_temperature_bed > current_temperature_bed;
};

inline bool isCoolingHotend(uint8_t PROBE) {  
  return target_temperature[PROBE] < current_temperature[PROBE];
};

inline bool isCoolingBed() {
  return target_temperature_bed < current_temperature_bed;
};

#define degHotend0() degHotend(0)
#define degTargetHotend0() degTargetHotend(0)
#define setTargetHotend0(_celsius) setTargetHotend((_celsius), 0)
#define isHeatingHotend0() isHeatingHotend(0)
#define isCoolingHotend0() isCoolingHotend(0)
#if PROBES > 1
#define degHotend1() degHotend(1)
#define degTargetHotend1() degTargetHotend(1)
#define setTargetHotend1(_celsius) setTargetHotend((_celsius), 1)
#define isHeatingHotend1() isHeatingHotend(1)
#define isCoolingHotend1() isCoolingHotend(1)
#else
#define setTargetHotend1(_celsius) do{}while(0)
#endif
#if PROBES > 2
#define degHotend2() degHotend(2)
#define degTargetHotend2() degTargetHotend(2)
#define setTargetHotend2(_celsius) setTargetHotend((_celsius), 2)
#define isHeatingHotend2() isHeatingHotend(2)
#define isCoolingHotend2() isCoolingHotend(2)
#else
#define setTargetHotend2(_celsius) do{}while(0)
#endif
#if PROBES > 3
#error Invalid number of PROBES
#endif



int getHeaterPower(int heater);
void disable_heater();
void setWatch();
void updatePID();

#if (defined (THERMAL_RUNAWAY_PROTECTION_PERIOD) && THERMAL_RUNAWAY_PROTECTION_PERIOD > 0) || (defined (THERMAL_RUNAWAY_PROTECTION_BED_PERIOD) && THERMAL_RUNAWAY_PROTECTION_BED_PERIOD > 0)
void thermal_runaway_protection(int *state, unsigned long *timer, float temperature, float target_temperature, int heater_id, int period_seconds, int hysteresis_degc);
static int thermal_runaway_state_machine[3]; // = {0,0,0};
static unsigned long thermal_runaway_timer[3]; // = {0,0,0};
static bool thermal_runaway = false;
  #if TEMP_SENSOR_BED != 0
    static int thermal_runaway_bed_state_machine;
    static unsigned long thermal_runaway_bed_timer;
  #endif
#endif

inline void autotempShutdown(){
 #ifdef AUTOTEMP
 if(autotemp_enabled)
 {
  autotemp_enabled=false;
  if(degTargetHotend(active_PROBE)>autotemp_min)
    setTargetHotend(0,active_PROBE);
 }
 #endif
}

void PID_autotune(float temp, int PROBE, int ncycles);

void setPROBEAutoFanState(int pin, bool state);
void checkPROBEAutoFans();

#endif
