crice009/CountertopIncubator/(commit log)

2017-12-29 inital upload
    [Configuration.h, Configuration_adv.h, DXF_Back.dxf, DXF_Back_Clip.dxf, DXF_Back_Clip_2x.dxf, DXF_Bottom.dxf, DXF_Bottom2.dxf, DXF_Bottom3.dxf]
2018-01-02 circuit image
2018-01-04 marlin work
2018-01-04 understanding marlin
    [Configuration.h]
2018-01-05 continuing with temp files...
    [Configuration.h]
2018-01-07 finally building a tempTest that is based on what is needed...
    [Configuration.h]
2018-01-08 simple working version
    [Configuration.h, thermistor.xlsx]
2018-01-08 organized arduino
    [Configuration.h, Configuration_adv.h]
2018-01-10 3d model file
    [DXF_Back.dxf, DXF_Back_Clip.dxf, DXF_Back_Clip_2x.dxf, DXF_Bottom.dxf, DXF_Bottom2.dxf, DXF_Bottom3.dxf, DXF_Bottom4.dxf, DXF_Button_Panel.dxf]
2018-01-13 still working on count up timer
2018-01-15 timer appearance
2018-01-15 bill of materials
    [billofmaterials.csv]
2018-01-15 BOM narrative
2018-01-15 file structure
    [Configuration.h, Configuration_adv.h, thermistor.xlsx]
